FeministHardware/Making-PCBs-from-natural-clay/NaturalPCB-pinout.png

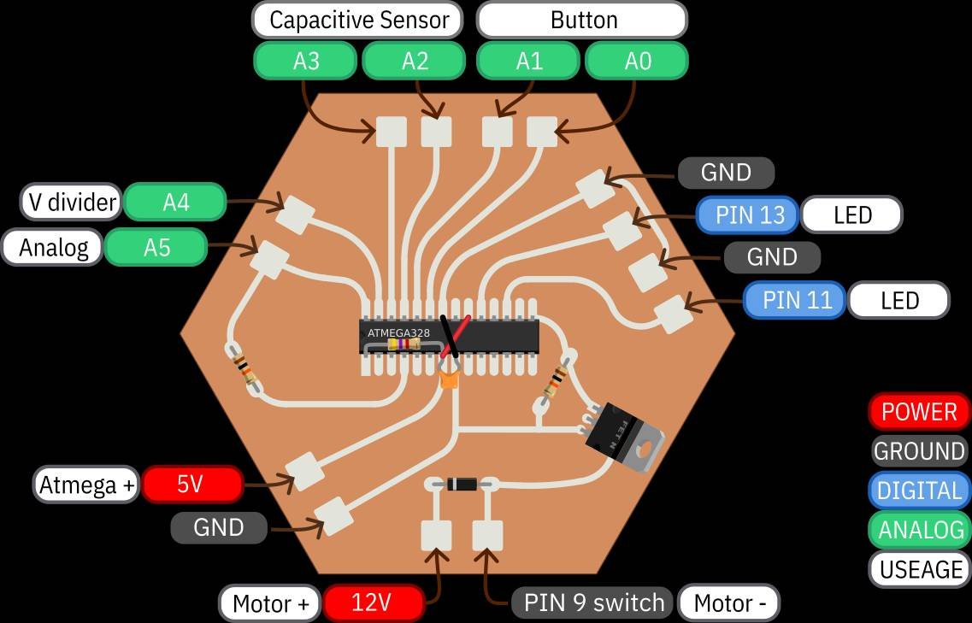
NaturalPCB-pinout.png
