FeministHardware/Making-PCBs-from-natural-clay/PCB_caption.jpg

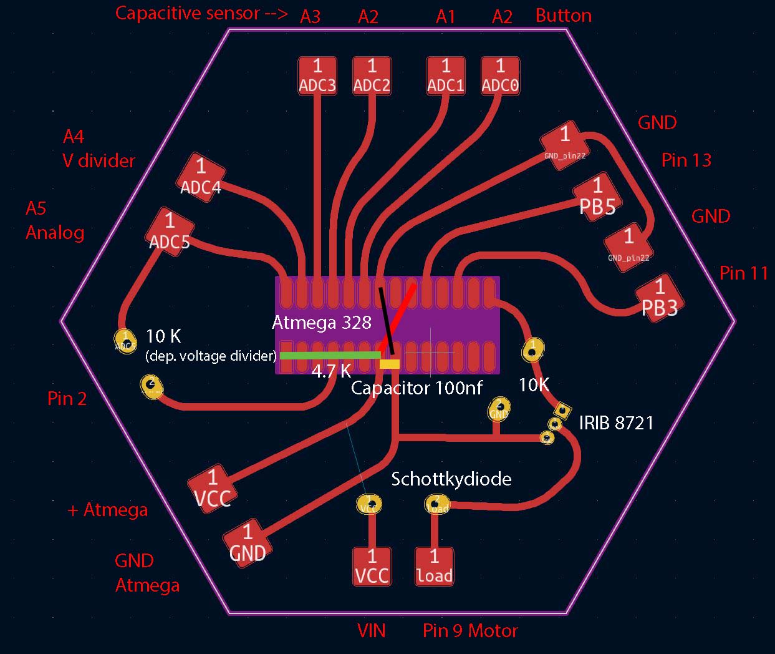
PCB_caption.jpg
