FeministHardware/Making-PCBs-from-natural-clay/PCB_Clay_final_bb.jpg

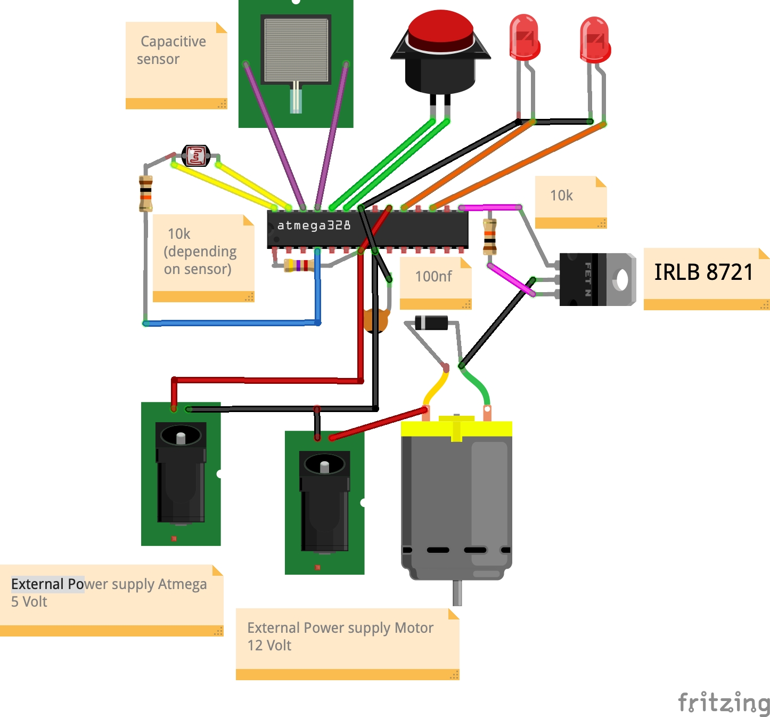
PCB_Clay_final_bb.jpg
