FeministHardware/Making-PCBs-from-natural-clay/3D_print/ceramic-PCB-stamp-2023-10.3mf

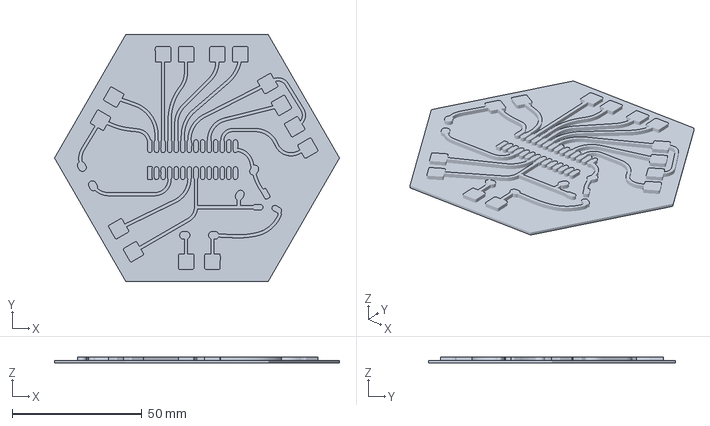
[picture p4: CAD file, 2023-10-17]
3D_print/ceramic-PCB-stamp-2023-10.3mf
110.0 x 95.3 x 2.40 mm
