FeministHardware/Making-PCBs-from-natural-clay/3D_print/hex-tile-rounded v8.step

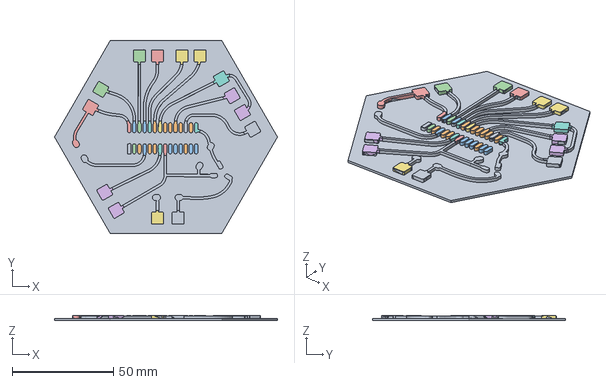
[picture p5: CAD file, 2023-10-17]
3D_print/hex-tile-rounded v8.step
110.0 x 95.3 x 2.60 mm
