FeministHardware/Making-PCBs-from-natural-clay/(list of files, cad)

Other CAD files:
3D_print/Ceramic-PCB-stamp-2023-10.stl
3D_print/PCB-stamp-rounded.f3d
