FeministHardware/Making-PCBs-from-natural-clay/(commit log)

2023-10-17 Diagram circuit
2023-10-17 3D printing files
    [Ceramic-PCB-stamp-2023-10.stl, PCB-stamp-rounded.f3d, ceramic-PCB-stamp-2023-10.3mf, hex-tile-rounded v8.step]
